yellobyte/YB-ESP32-S3-RS485/doc/YB-ESP32-S3-RS485_ArduinoIDE_Board-Selection.jpg

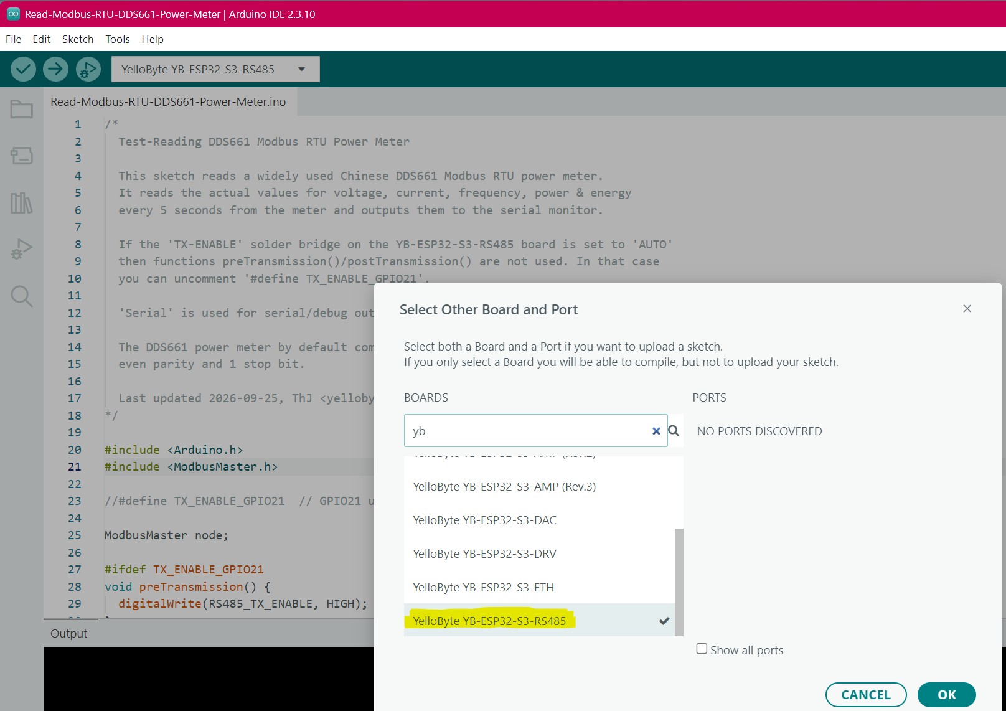
doc/YB-ESP32-S3-RS485_ArduinoIDE_Board-Selection.jpg
