yellobyte/YB-ESP32-S3-RS485/doc/YB-ESP32-S3-RS485_on_breadboard.jpg

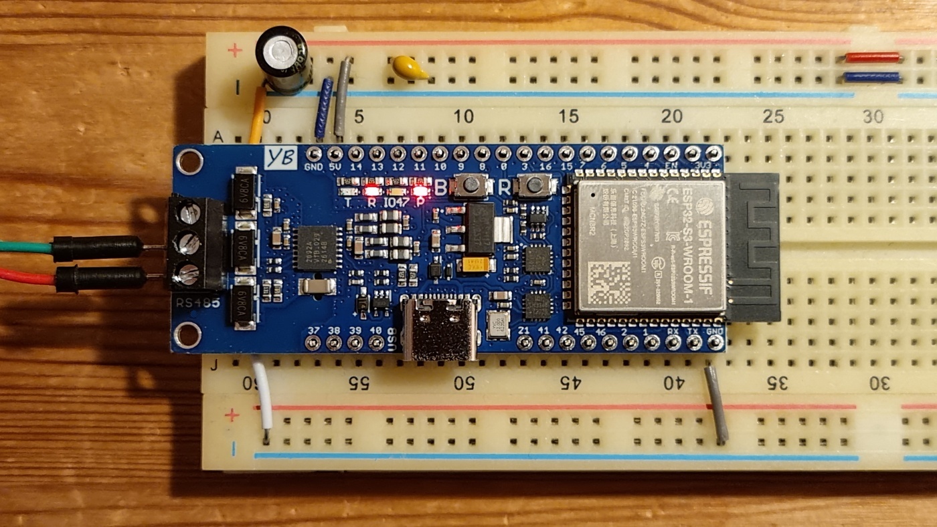
doc/YB-ESP32-S3-RS485_on_breadboard.jpg
