yellobyte/YB-ESP32-S3-RS485/doc/YB-ESP32-S3-RS485_reading_DDS661-Single-Phase-Meter.jpg

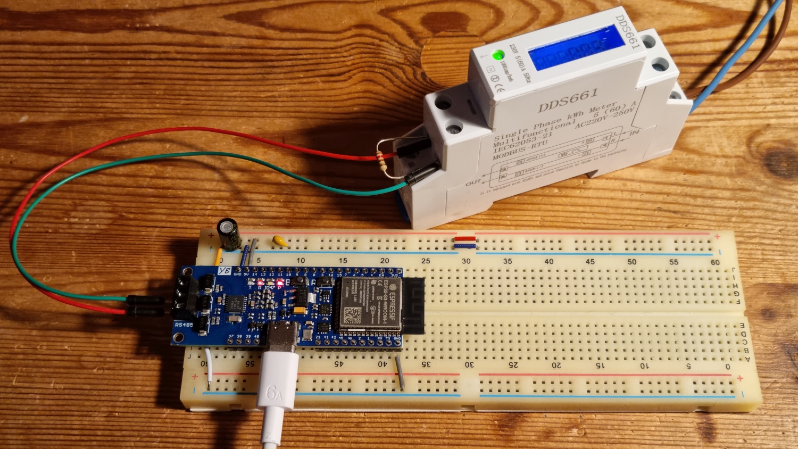
doc/YB-ESP32-S3-RS485_reading_DDS661-Single-Phase-Meter.jpg
