yellobyte/YB-ESP32-S3-RS485/doc/YB-ESP32-S3-RS485_schematic_1-2.jpg

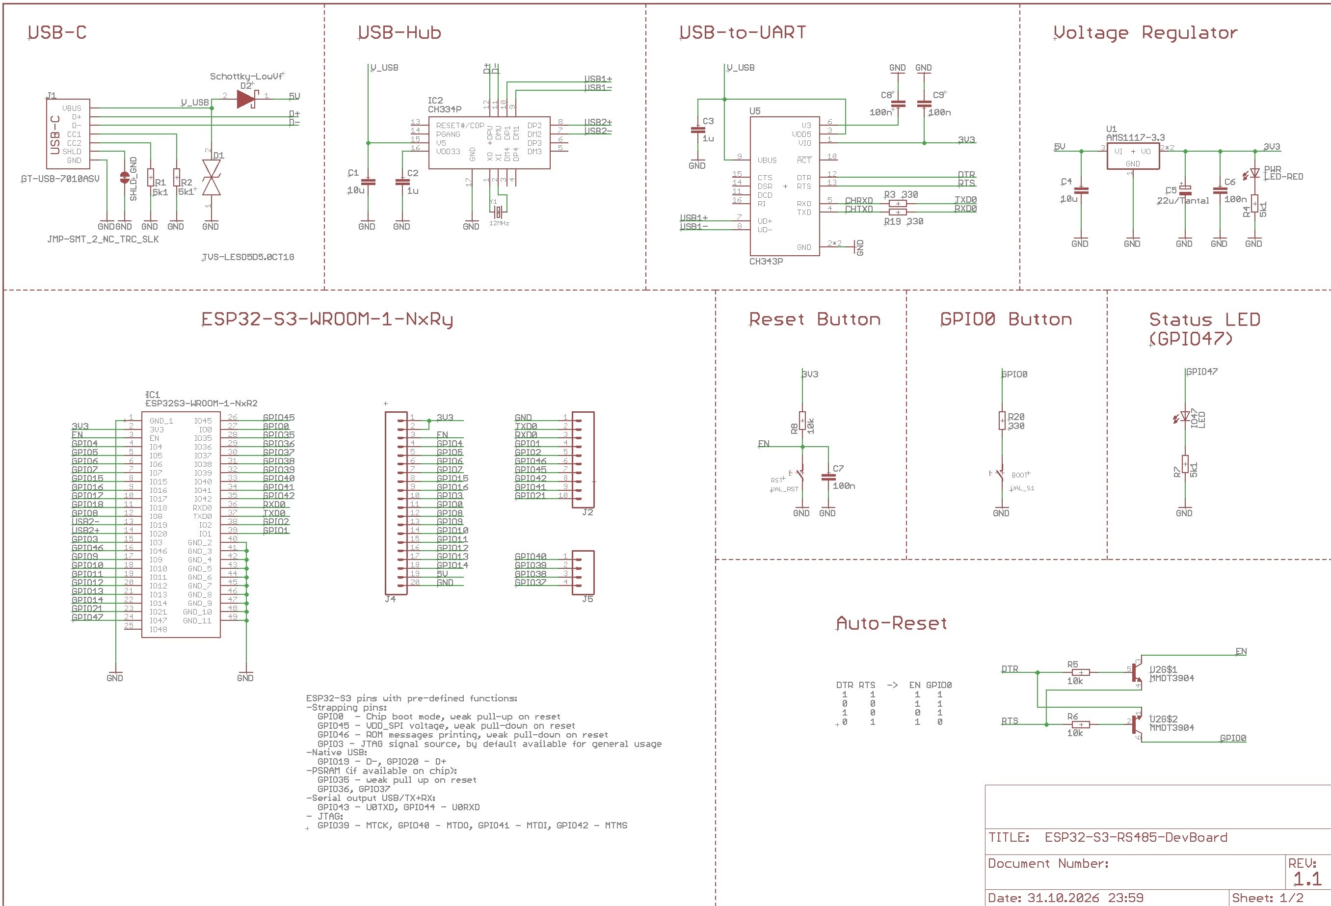
doc/YB-ESP32-S3-RS485_schematic_1-2.jpg
